heinzboehmer/BlueBus/hardware/BlueBus.brd

## EAGLE design hardware/BlueBus.brd (2020-11-15)

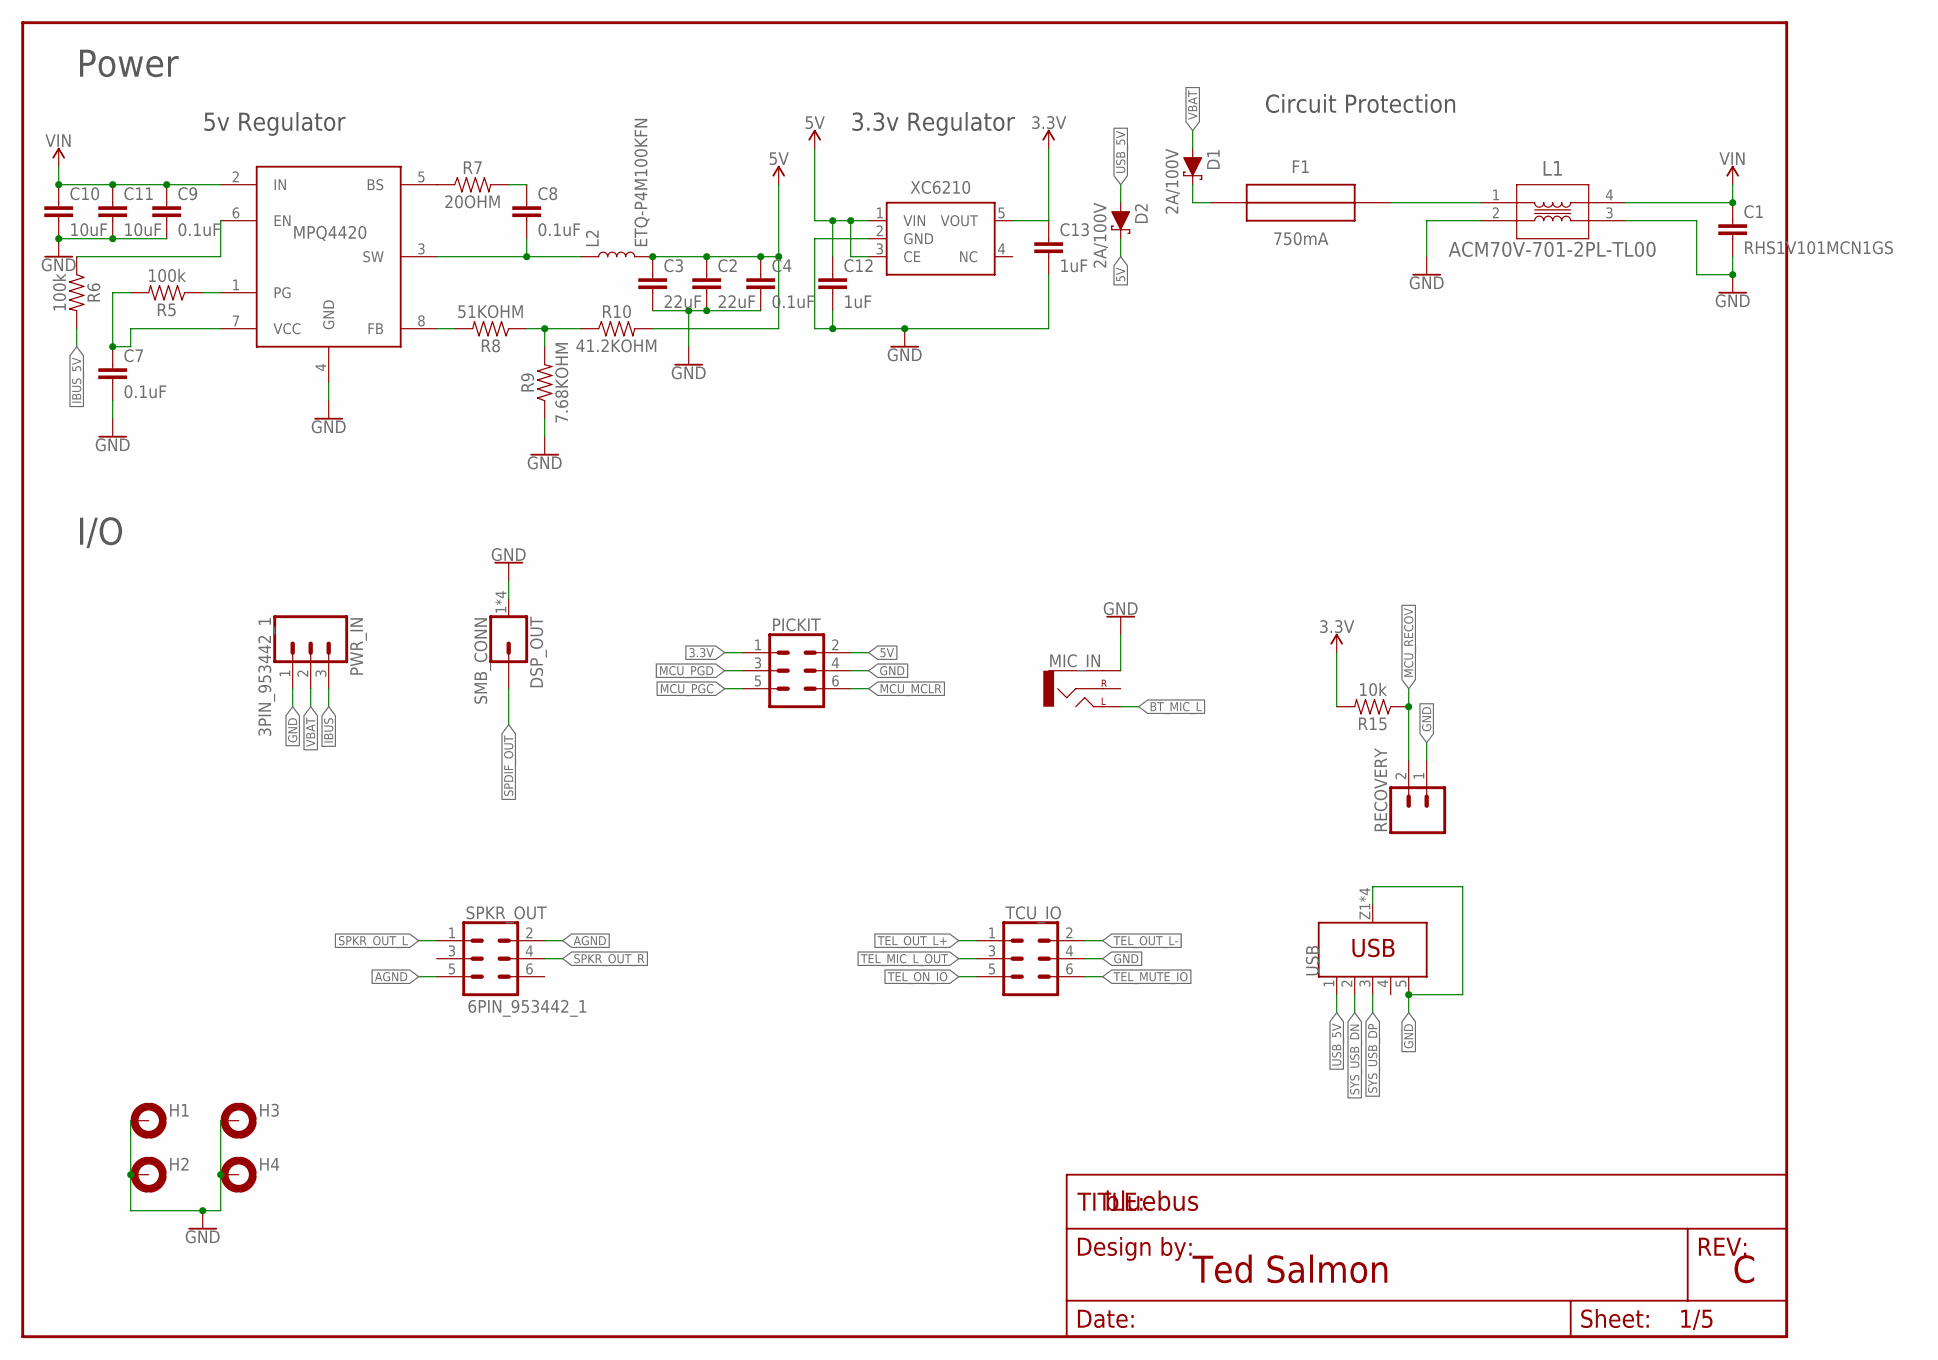
[picture p1: schematic BlueBus.sch, sheet 1]

Parts:
C1: RHS1V101MCN1GS
C2, C3: 22uF; 0805
C4, C7, C8, C9: 0.1uF; 0805
C10, C11: 10uF; 1206
C12, C13: 1uF; 0805
D1, D2: 2A/100V; SOD123
DSP_OUT: SMB_CONN; MOLEX_SMB
F1: 750mA; LITTLEFUSE
FRAME1: FRAME-LETTER; DUMMY
H1, H2, H3, H4: 2,0-PAD; 2.0-PAD
L1: ACM70V-701-2PL-TL00
L2: ETQ-P4M100KFN; PCC-M0648M-LE
MIC_IN: AUDIO-CUI-SJ-3523-SMT; AUDIO-CUI-SJ-352X-SMT
MPQ4420: MPQ4420; TSOT23-8
PICKIT: 6PIN_JUMPER; 2X3
PWR_IN: 3PIN_953442_1; TE_MQS_3PIN
R5, R6: 100k; 0805
R7: 20OHM; 0805
R8: 51KOHM; 0805
R9: 7.68KOHM; 0805
R10: 41.2KOHM; 0805
R15: 10k; 0805
RECOVERY: 2PIN_JUMPER; 1X02
SPKR_OUT: 6PIN_953442_1; TE_MQS_6PIN
TCU_IO: 6PIN_5_103166_1; TE_AMPMODU_6_PIN
USB: USB_WURTH_629105150521; 629105150521
XC6210: XC6210SOT25; SOT23-5

Connections:
3.3V: C13.1, PICKIT.1, R15.2, XC6210.5 (VOUT); also elsewhere on the board
5V: C2.1, C3.1, C4.1, C12.1, D2.C, L2.2, PICKIT.2, R10.2, XC6210.1 (VIN), XC6210.3 (CE); also elsewhere on the board
5VREG_BS: MPQ4420.5 (BS), R7.1
5VREG_BS_CAP: C8.1, R7.2
5VREG_EN: MPQ4420.6 (EN), R6.1
5VREG_FB: MPQ4420.8 (FB), R8.2
5VREG_FB_T: R8.1, R9.2, R10.1
5VREG_PG: MPQ4420.1 (PG), R5.1
5VREG_SW: C8.2, L2.1, MPQ4420.3 (SW)
5VREG_VCC: C7.1, MPQ4420.7 (VCC), R5.2
AGND: SPKR_OUT.2, SPKR_OUT.5; also elsewhere on the board
BT_MIC_L: MIC_IN.TIP (LEFT); also elsewhere on the board
GND: C1.2, C2.2, C3.2, C4.2, C7.2, C9.2, C10.2, C11.2, C12.2, C13.2, DSP_OUT.1 (GND), DSP_OUT.2 (GND), DSP_OUT.3 (GND), DSP_OUT.4 (GND), H1.B2,0, H2.B2,0, H3.B2,0, H4.B2,0, L1.2, L1.3, MIC_IN.SLEEVE, MPQ4420.4 (GND), PICKIT.4, PWR_IN.1, R9.1, RECOVERY.1, TCU_IO.4, USB.5 (GND), USB.Z1 (SHIELD), USB.Z2 (SHIELD), USB.Z3 (SHIELD), USB.Z4 (SHIELD), XC6210.2 (GND); also elsewhere on the board
IBUS: PWR_IN.3; also elsewhere on the board
IBUS_5V: R6.2; also elsewhere on the board
MCU_MCLR: PICKIT.6; also elsewhere on the board
MCU_PGC: PICKIT.5; also elsewhere on the board
MCU_PGD: PICKIT.3; also elsewhere on the board
MCU_RECOV: R15.1, RECOVERY.2; also elsewhere on the board
SPDIF_OUT: DSP_OUT.P$1 (1); also elsewhere on the board
SPKR_OUT_L: SPKR_OUT.1; also elsewhere on the board
SPKR_OUT_R: SPKR_OUT.4; also elsewhere on the board
SYS_USB_DN: USB.2 (D-); also elsewhere on the board
SYS_USB_DP: USB.3 (D+); also elsewhere on the board
TEL_MIC_L_OUT: TCU_IO.3; also elsewhere on the board
TEL_MUTE_IO: TCU_IO.6; also elsewhere on the board
TEL_ON_IO: TCU_IO.5; also elsewhere on the board
TEL_OUT_L+: TCU_IO.1; also elsewhere on the board
TEL_OUT_L-: TCU_IO.2; also elsewhere on the board
USB_5V: D2.A, USB.1 (VBUS)
VBAT: D1.A, PWR_IN.2
VBAT_DIODE: D1.C, F1.IN (OUT)
VBAT_FUSE: F1.OUT (IN), L1.1
VIN: C1.1, C9.1, C10.1, C11.1, L1.4, MPQ4420.2 (IN); also elsewhere on the board

Notes on the sheet:
Ted Salmon
Power
I/O
3.3v Regulator
5v Regulator
Circuit Protection

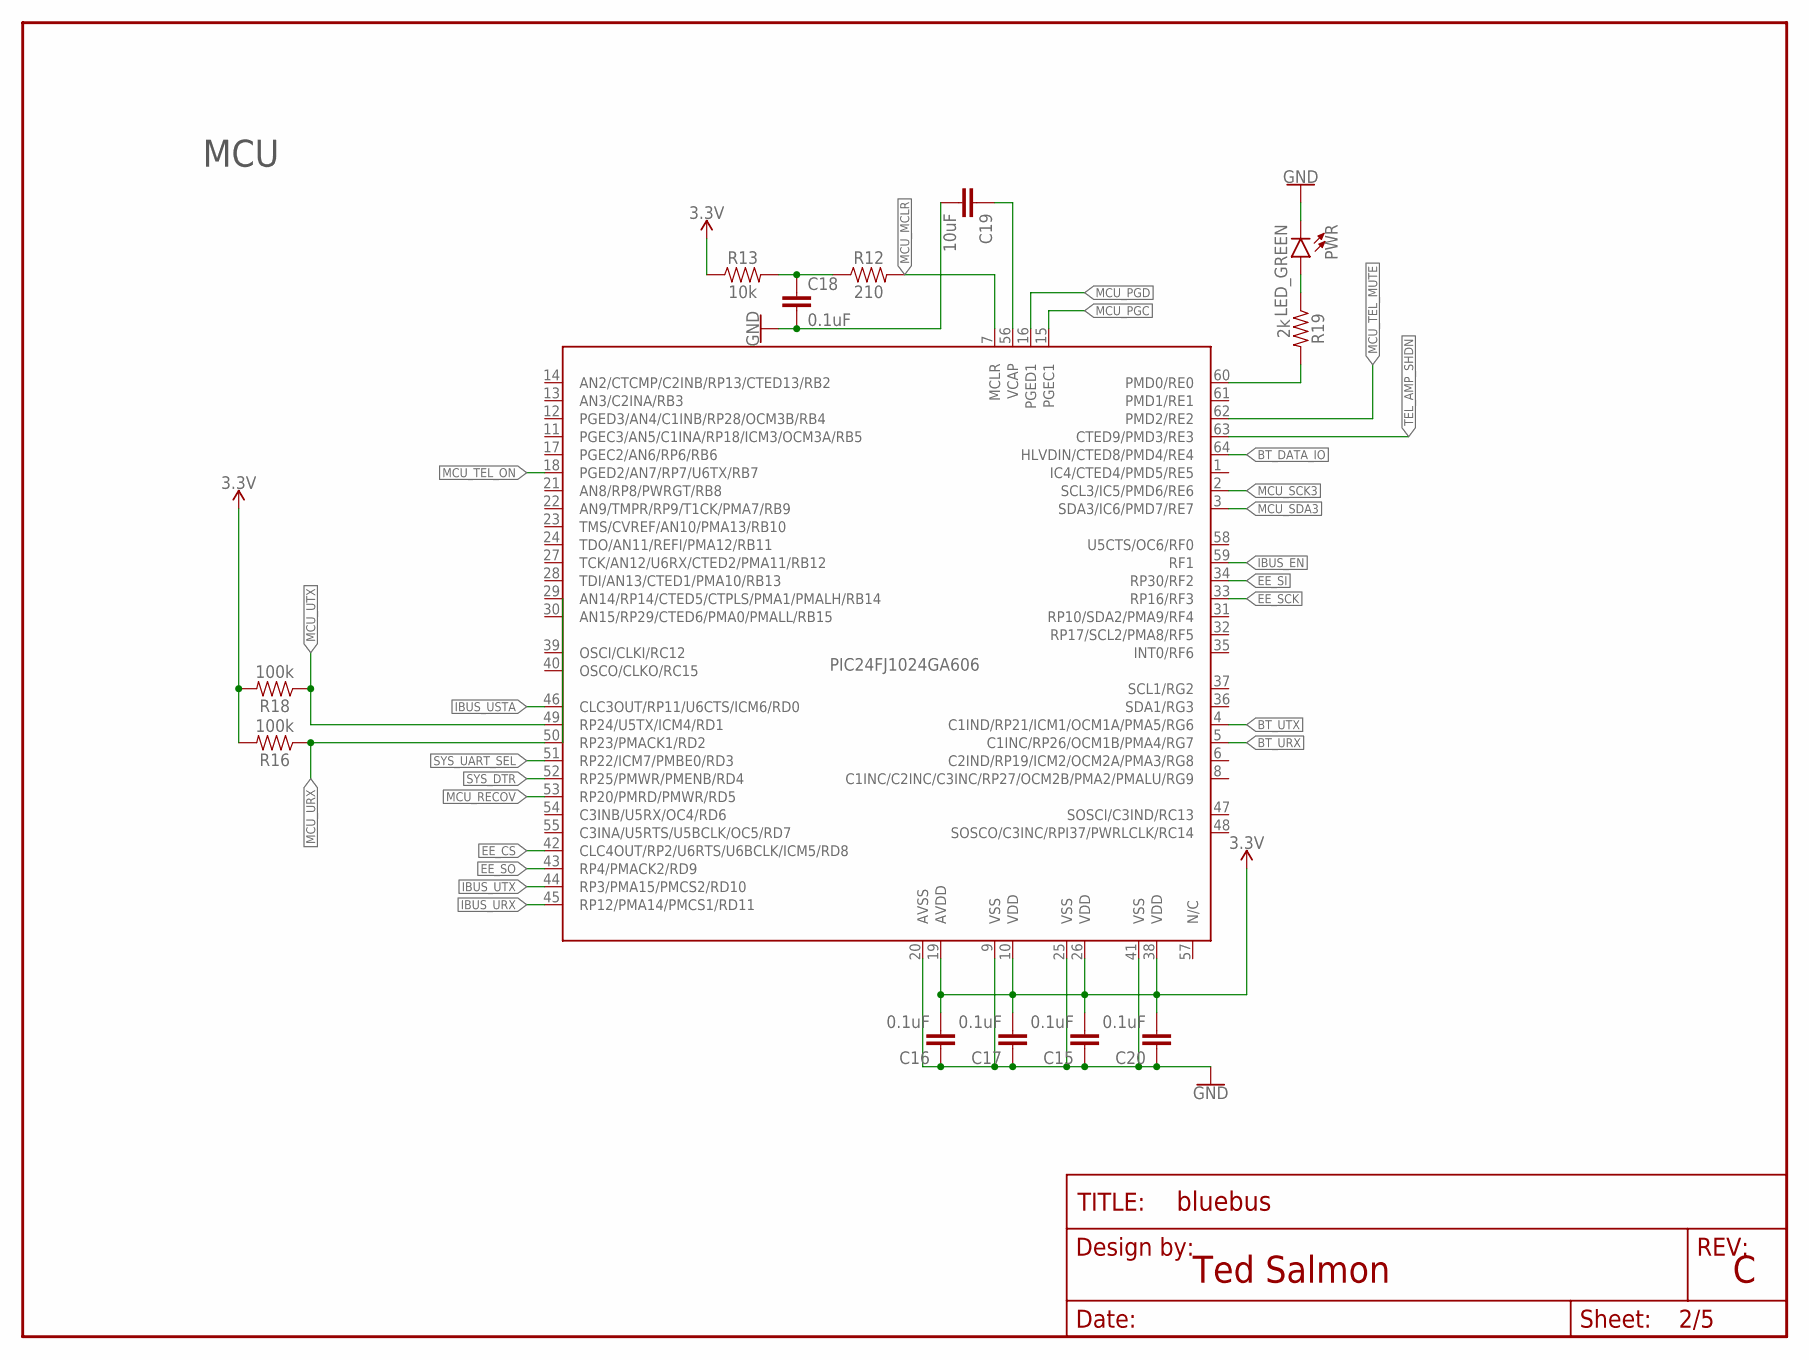
[picture p2: schematic BlueBus.sch, sheet 2]

Parts:
C15, C16, C17, C18, C20: 0.1uF; 0805
C19: 10uF; 0805
FRAME2: FRAME-LETTER; DUMMY
PIC24FJ1024GA606: PIC24FJ1024GA606; TQFP64
PWR: LED_GREEN; LED-0805
R12: 210; 0805
R13: 10k; 0805
R16, R18: 100k; 0805
R19: 2k; 0805

Connections:
3.3V: C15.2, C16.2, C17.2, C20.2, PIC24FJ1024GA606.10 (VDD), PIC24FJ1024GA606.19 (AVDD), PIC24FJ1024GA606.26 (VDD), PIC24FJ1024GA606.38 (VDD), R13.1, R16.2, R18.2; also elsewhere on the board
BT_DATA_IO: PIC24FJ1024GA606.64 (HLVDIN/CTED8/PMD4/RE4); also elsewhere on the board
BT_URX: PIC24FJ1024GA606.5 (C1INC/RP26/OCM1B/PMA4/RG7); also elsewhere on the board
BT_UTX: PIC24FJ1024GA606.4 (C1IND/RP21/ICM1/OCM1A/PMA5/RG6); also elsewhere on the board
EE_CS: PIC24FJ1024GA606.42 (CLC4OUT/RP2/U6RTS/U6BCLK/ICM5/RD8); also elsewhere on the board
EE_SCK: PIC24FJ1024GA606.33 (RP16/RF3); also elsewhere on the board
EE_SI: PIC24FJ1024GA606.34 (RP30/RF2); also elsewhere on the board
EE_SO: PIC24FJ1024GA606.43 (RP4/PMACK2/RD9); also elsewhere on the board
GND: C15.1, C16.1, C17.1, C18.2, C19.2, C20.1, PIC24FJ1024GA606.9 (VSS), PIC24FJ1024GA606.20 (AVSS), PIC24FJ1024GA606.25 (VSS), PIC24FJ1024GA606.41 (VSS), PWR.- (C); also elsewhere on the board
IBUS_EN: PIC24FJ1024GA606.59 (RF1); also elsewhere on the board
IBUS_URX: PIC24FJ1024GA606.45 (RP12/PMA14/PMCS1/RD11); also elsewhere on the board
IBUS_USTA: PIC24FJ1024GA606.46 (CLC3OUT/RP11/U6CTS/ICM6/RD0); also elsewhere on the board
IBUS_UTX: PIC24FJ1024GA606.44 (RP3/PMA15/PMCS2/RD10); also elsewhere on the board
MCU_MCLR: PIC24FJ1024GA606.7 (MCLR), R12.2; also elsewhere on the board
MCU_MCLR_RES: C18.1, R12.1, R13.2
MCU_ON_LED: PIC24FJ1024GA606.60 (PMD0/RE0), R19.2
MCU_ON_LED_RES: PWR.+ (A), R19.1
MCU_PGC: PIC24FJ1024GA606.15 (PGEC1); also elsewhere on the board
MCU_PGD: PIC24FJ1024GA606.16 (PGED1); also elsewhere on the board
MCU_RECOV: PIC24FJ1024GA606.53 (RP20/PMRD/PMWR/RD5); also elsewhere on the board
MCU_SCK3: PIC24FJ1024GA606.2 (SCL3/IC5/PMD6/RE6); also elsewhere on the board
MCU_SDA3: PIC24FJ1024GA606.3 (SDA3/IC6/PMD7/RE7); also elsewhere on the board
MCU_TEL_MUTE: PIC24FJ1024GA606.62 (PMD2/RE2); also elsewhere on the board
MCU_TEL_ON: PIC24FJ1024GA606.18 (PGED2/AN7/RP7/U6TX/RB7); also elsewhere on the board
MCU_URX: PIC24FJ1024GA606.50 (RP23/PMACK1/RD2), R16.1; also elsewhere on the board
MCU_UTX: PIC24FJ1024GA606.49 (RP24/U5TX/ICM4/RD1), R18.1; also elsewhere on the board
MCU_VCAP: C19.1, PIC24FJ1024GA606.56 (VCAP)
SYS_DTR: PIC24FJ1024GA606.52 (RP25/PMWR/PMENB/RD4); also elsewhere on the board
SYS_UART_SEL: PIC24FJ1024GA606.51 (RP22/ICM7/PMBE0/RD3); also elsewhere on the board
TEL_AMP_SHDN: PIC24FJ1024GA606.63 (CTED9/PMD3/RE3); also elsewhere on the board

Notes on the sheet:
Ted Salmon
MCU

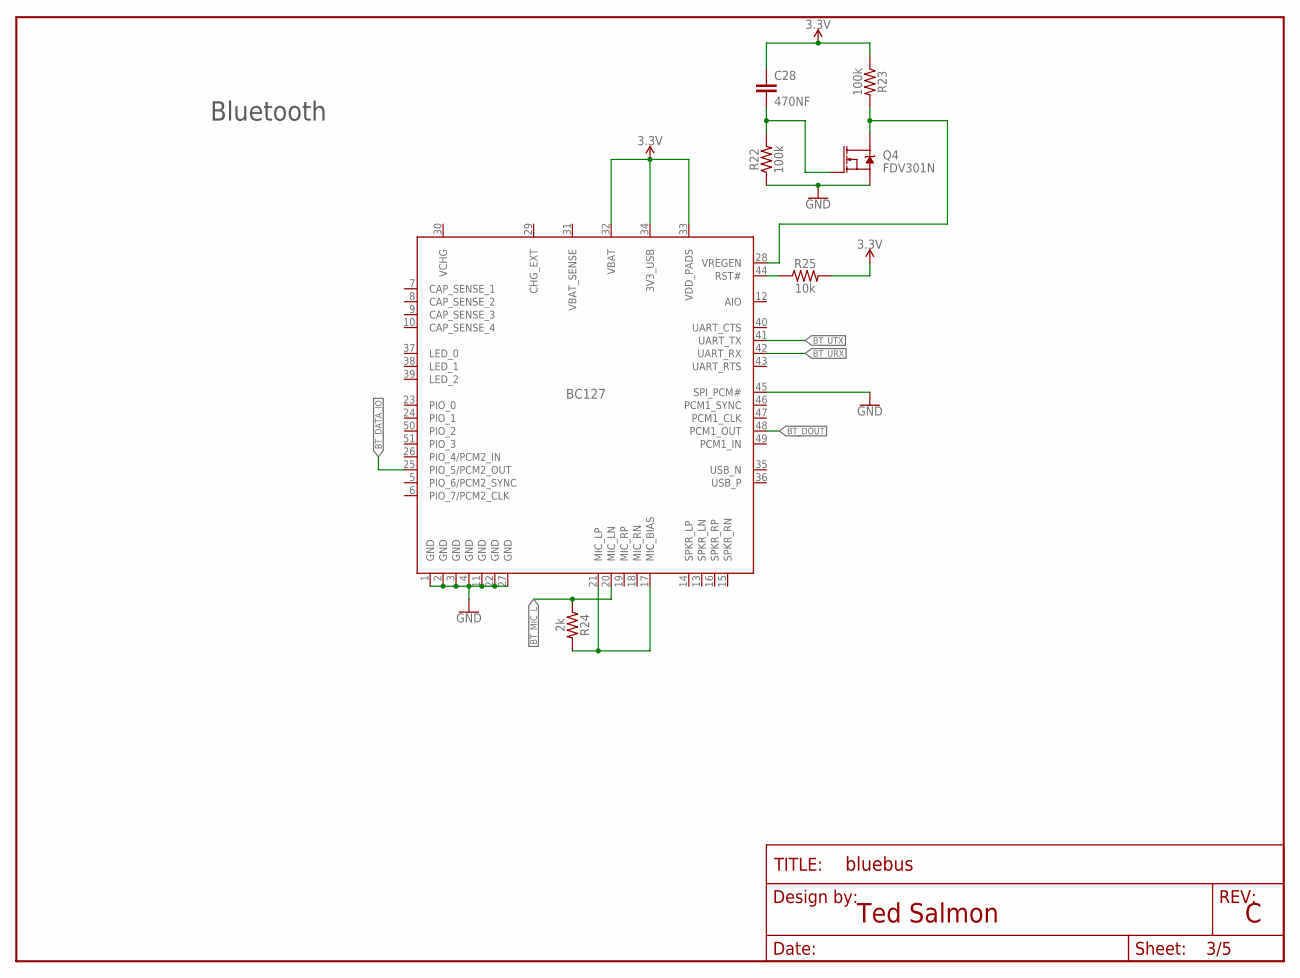
[picture p3: schematic BlueBus.sch, sheet 3]

Parts:
BC127: BC127
C28: 470NF; 0805
FRAME4: FRAME-LETTER; DUMMY
Q4: FDV301N; SOT-23
R22, R23: 100k; 0805
R24: 2k; 0805
R25: 10k; 0805

Connections:
3.3V: BC127.32 (VBAT), BC127.33 (VDD_PADS), BC127.34 (3V3_USB), C28.1, R23.1, R25.2; also elsewhere on the board
BT_DATA_IO: BC127.25 (PIO_5/PCM2_OUT); also elsewhere on the board
BT_DOUT: BC127.48 (PCM1_OUT); also elsewhere on the board
BT_MIC_BIAS: BC127.17 (MIC_BIAS), BC127.21 (MIC_LP), R24.2
BT_MIC_L: BC127.20 (MIC_LN), R24.1; also elsewhere on the board
BT_RST: BC127.44 (RST#), R25.1
BT_URX: BC127.42 (UART_RX); also elsewhere on the board
BT_UTX: BC127.41 (UART_TX); also elsewhere on the board
BT_VREGEN: BC127.28 (VREGEN), Q4.3 (D), R23.2
BT_VREGEN_CAP_GATE: C28.2, Q4.1 (G), R22.2
CHG_EXT: BC127.29 (CHG_EXT)
GND: BC127.1 (GND), BC127.2 (GND), BC127.3 (GND), BC127.4 (GND), BC127.11 (GND), BC127.22 (GND), BC127.27 (GND), BC127.45 (SPI_PCM#), Q4.2 (S), R22.1; also elsewhere on the board
VBAT_SENSE: BC127.31 (VBAT_SENSE)
VCHG: BC127.30 (VCHG)

Notes on the sheet:
Bluetooth
Ted Salmon

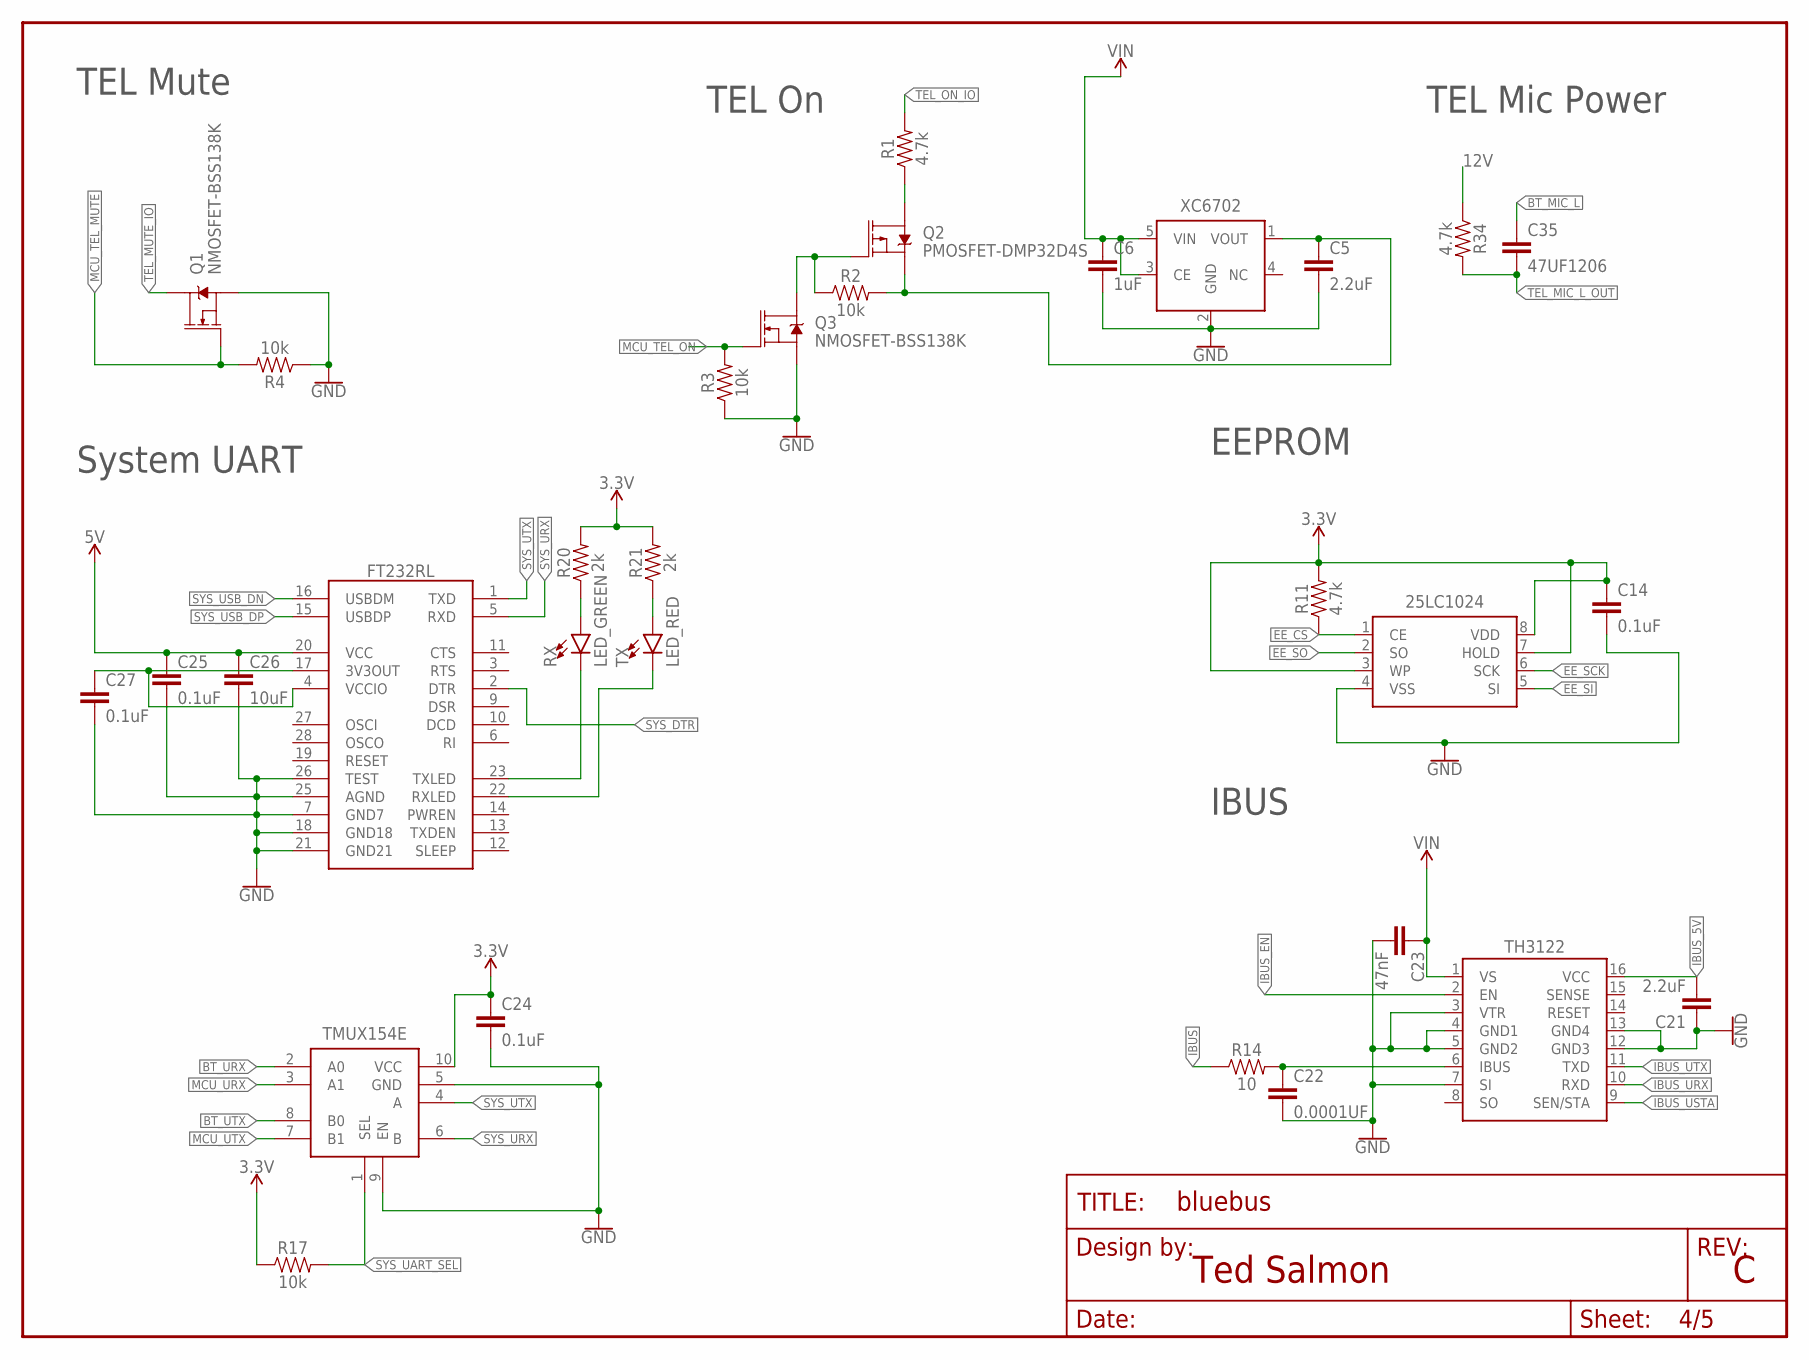
[picture p4: schematic BlueBus.sch, sheet 4]

Parts:
25LC1024: 25LC1024; SOIJ-8
C5, C21: 2.2uF; 0805
C6: 1uF; 0805
C14, C24, C25, C27: 0.1uF; 0805
C22: 0.0001UF; 0805
C23: 47nF; 0805
C26: 10uF; 0805
C35: 47UF1206; 1206
FRAME3: FRAME-LETTER; DUMMY
FT232RL: FT232RL; SSOP28
Q1, Q3: NMOSFET-BSS138K; SOT-23
Q2: PMOSFET-DMP32D4S; SOT-23
R1, R11, R34: 4.7k; 0805
R2, R3, R4, R17: 10k; 0805
R14: 10; 0805
R20, R21: 2k; 0805
RX: LED_GREEN; LED-0805
TH3122: TH3122.4; SOIC16DF
TMUX154E: TMUX154E; VSSOP10
TX: LED_RED; LED-0805
XC6702: XC6702DC018PR-G; SOT-89-5

Connections:
3.3V: 25LC1024.3 (WP), 25LC1024.7 (HOLD), 25LC1024.8 (VDD), C14.1, C24.1, R11.2, R17.1, R20.2, R21.2, TMUX154E.10 (VCC); also elsewhere on the board
5V: C25.1, C26.1, FT232RL.20 (VCC); also elsewhere on the board
12V: C5.1, Q2.2 (S), R2.2, R34.1, XC6702.1 (VOUT)
BT_MIC_L: C35.1; also elsewhere on the board
BT_URX: TMUX154E.2 (A0); also elsewhere on the board
BT_UTX: TMUX154E.8 (B0); also elsewhere on the board
EE_CS: 25LC1024.1 (CE), R11.1; also elsewhere on the board
EE_SCK: 25LC1024.6 (SCK); also elsewhere on the board
EE_SI: 25LC1024.5 (SI); also elsewhere on the board
EE_SO: 25LC1024.2 (SO); also elsewhere on the board
GND: 25LC1024.4 (VSS), C5.2, C6.2, C14.2, C21.1, C22.2, C23.2, C24.2, C25.2, C26.2, C27.2, FT232RL.7 (GND7), FT232RL.18 (GND18), FT232RL.21 (GND21), FT232RL.25 (AGND), FT232RL.26 (TEST), Q1.2 (S), Q3.2 (S), R3.1, R4.1, TH3122.3 (VTR), TH3122.4 (GND1), TH3122.5 (GND2), TH3122.7 (SI), TH3122.12 (GND3), TH3122.13 (GND4), TMUX154E.5 (GND), TMUX154E.9 (EN), XC6702.2 (GND); also elsewhere on the board
IBUS: R14.1; also elsewhere on the board
IBUS_5V: C21.2, TH3122.16 (VCC); also elsewhere on the board
IBUS_EN: TH3122.2 (EN); also elsewhere on the board
IBUS_FILT: C22.1, R14.2, TH3122.6 (IBUS)
IBUS_URX: TH3122.10 (RXD); also elsewhere on the board
IBUS_USTA: TH3122.9 (SEN/STA); also elsewhere on the board
IBUS_UTX: TH3122.11 (TXD); also elsewhere on the board
MCU_TEL_MUTE: Q1.1 (G), R4.2; also elsewhere on the board
MCU_TEL_ON: Q3.1 (G), R3.2; also elsewhere on the board
MCU_URX: TMUX154E.3 (A1); also elsewhere on the board
MCU_UTX: TMUX154E.7 (B1); also elsewhere on the board
RX_LED: FT232RL.23 (TXLED), RX.- (C)
RX_LED_RES: R20.1, RX.+ (A)
SYS_3V3: C27.1, FT232RL.4 (VCCIO), FT232RL.17 (3V3OUT)
SYS_DTR: FT232RL.2 (DTR); also elsewhere on the board
SYS_UART_SEL: R17.2, TMUX154E.1 (SEL); also elsewhere on the board
SYS_URX: FT232RL.5 (RXD), TMUX154E.6 (B)
SYS_USB_DN: FT232RL.16 (USBDM); also elsewhere on the board
SYS_USB_DP: FT232RL.15 (USBDP); also elsewhere on the board
SYS_UTX: FT232RL.1 (TXD), TMUX154E.4 (A)
TEL_MIC_L_OUT: C35.2, R34.2; also elsewhere on the board
TEL_MUTE_IO: Q1.3 (D); also elsewhere on the board
TEL_ON: Q2.3 (D), R1.1
TEL_ON_EN: Q2.1 (G), Q3.3 (D), R2.1
TEL_ON_IO: R1.2; also elsewhere on the board
TX_LED: FT232RL.22 (RXLED), TX.- (C)
TX_LED_RES: R21.1, TX.+ (A)
VIN: C6.1, C23.1, TH3122.1 (VS), XC6702.3 (CE), XC6702.5 (VIN); also elsewhere on the board

Notes on the sheet:
Ted Salmon
IBUS
EEPROM
TEL On
TEL Mute
TEL Mic Power
System UART

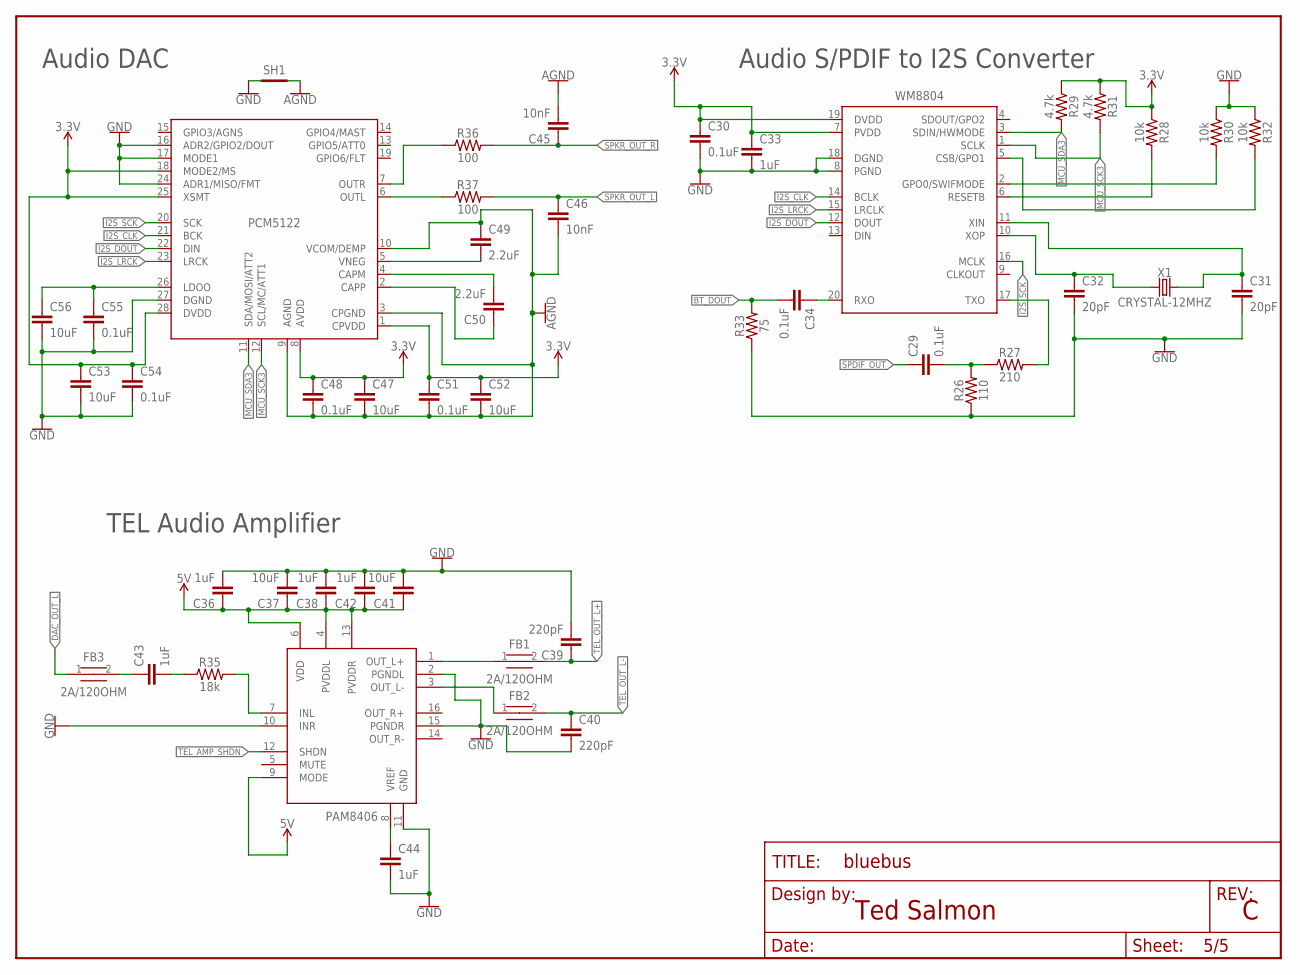
[picture p5: schematic BlueBus.sch, sheet 5]

Parts:
C29, C30, C34, C48, C51, C54, C55: 0.1uF; 0805
C31, C32: 20pF; 0805
C33, C36, C38, C42, C43, C44: 1uF; 0805
C37, C41, C47, C52, C53, C56: 10uF; 0805
C39, C40: 220pF; 0805
C45, C46: 10nF; 0805
C49, C50: 2.2uF; 0805
FB1, FB2, FB3: 2A/120OHM; 0805
FRAME5: FRAME-LETTER; DUMMY
PAM8406: PAM8406; SOP-16
PCM5122: PCM5122; TSSOP28
R26: 110; 0805
R27: 210; 0805
R28, R30, R32: 10k; 0805
R29, R31: 4.7k; 0805
R33: 75; 0805
R35: 18k; 0805
R36, R37: 100; 0805
SH1: SHORTT5; SHORT_TOP-50
WM8804: WM8804; SSOP20
X1: CRYSTAL-12MHZ; HC49

Connections:
3.3V: C30.1, C33.1, C47.1, C48.1, C51.1, C52.1, C53.1, C54.1, PCM5122.1 (CPVDD), PCM5122.8 (AVDD), PCM5122.18 (MODE2/MS), PCM5122.25 (XSMT), PCM5122.28 (DVDD), R28.1, R29.1, R31.1, WM8804.7 (PVDD), WM8804.19 (DVDD); also elsewhere on the board
5V: C36.1, C37.1, C38.1, C41.1, C42.1, PAM8406.4 (PVDDL), PAM8406.6 (VDD), PAM8406.9 (MODE), PAM8406.13 (PVDDR); also elsewhere on the board
AGND: C45.2, C46.2, C47.2, C48.2, C49.1, C51.2, C52.2, PCM5122.3 (CPGND), PCM5122.9 (AGND), PCM5122.10 (VCOM/DEMP), SH1.2; also elsewhere on the board
BT_DOUT: C34.2, R33.2; also elsewhere on the board
DAC_CAPM: C50.2, PCM5122.4 (CAPM)
DAC_CAPP: C50.1, PCM5122.2 (CAPP)
DAC_LDOO: C55.1, C56.1, PCM5122.26 (LDOO)
DAC_OUT_L: FB3.1, PCM5122.6 (OUTL), R37.1
DAC_OUT_R: PCM5122.7 (OUTR), R36.1
DAC_VNEG: C49.2, PCM5122.5 (VNEG)
GND: C30.2, C31.2, C32.2, C33.2, C36.2, C37.2, C38.2, C39.2, C40.2, C41.2, C42.2, C44.2, C53.2, C54.2, C55.2, C56.2, PAM8406.2 (PGNDL), PAM8406.10 (INR), PAM8406.11 (GND), PAM8406.15 (PGNDR), PCM5122.16 (ADR2/GPIO2/DOUT), PCM5122.17 (MODE1), PCM5122.24 (ADR1/MISO/FMT), PCM5122.27 (DGND), R26.1, R30.1, R32.1, R33.1, SH1.1, WM8804.8 (PGND), WM8804.18 (DGND); also elsewhere on the board
I2S_CLK: PCM5122.21 (BCK), WM8804.14 (BCLK)
I2S_DOUT: PCM5122.22 (DIN), WM8804.12 (DOUT)
I2S_LRCK: PCM5122.23 (LRCK), WM8804.15 (LRCLK)
I2S_SCK: PCM5122.20 (SCK), WM8804.16 (MCLK)
MCU_SCK3: PCM5122.12 (SCL/MC/ATT1), R31.2, WM8804.1 (SCLK); also elsewhere on the board
MCU_SDA3: PCM5122.11 (SDA/MOSI/ATT2), R29.2, WM8804.3 (SDIN/HWMODE); also elsewhere on the board
SPDIF_OUT: C29.1; also elsewhere on the board
SPDIF_RX: C34.1, WM8804.20 (RXO)
SPKR_OUT_L: C46.1, R37.2; also elsewhere on the board
SPKR_OUT_R: C45.1, R36.2; also elsewhere on the board
TEL_AMP_IN: C43.1, FB3.2
TEL_AMP_INL: PAM8406.7 (INL), R35.2
TEL_AMP_INL_CAP_RES: C43.2, R35.1
TEL_AMP_OUT_L+: FB1.1, PAM8406.1 (OUT_L+)
TEL_AMP_OUT_L-: FB2.1, PAM8406.3 (OUT_L-)
TEL_AMP_SHDN: PAM8406.12 (SHDN); also elsewhere on the board
TEL_AMP_VREF: C44.1, PAM8406.8 (VREF)
TEL_OUT_L+: C39.1, FB1.2; also elsewhere on the board
TEL_OUT_L-: C40.1, FB2.2; also elsewhere on the board
WM_CSB: R32.2, WM8804.5 (CSB/GPO1)
WM_GPO0: R30.2, WM8804.2 (GPO0/SWIFMODE)
WM_RESETB: R28.2, WM8804.6 (RESETB)
WM_SPDIF_TX_RES: R27.2, WM8804.17 (TXO)
WM_SPDIF_TX_RES2: C29.2, R26.2, R27.1
WM_XIN: C31.1, WM8804.11 (XIN), X1.2
WM_XOP: C32.1, WM8804.10 (XOP), X1.1

Notes on the sheet:
Audio DAC
Audio S/PDIF to I2S Converter
TEL Audio Amplifier
Ted Salmon

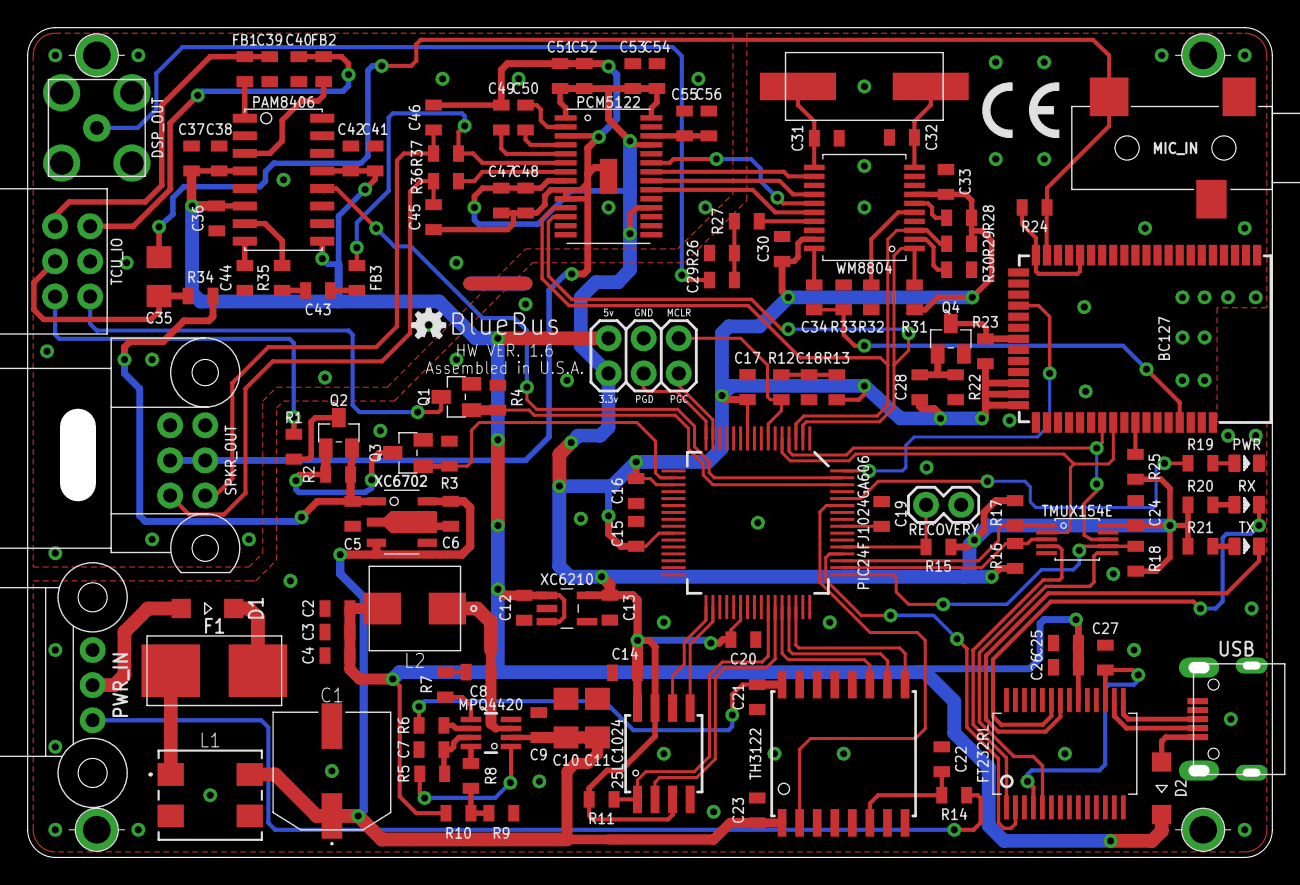
[picture p6: board BlueBus.brd from above]

Board: 2 copper layers, 90.0 x 60.0 mm, 141 parts (0 on the bottom side), 98 nets.

Other parts of the board:
CE: CE-4MM
OSHW: OSHW-LOGO-MINI
